cdsteinkuehler/LinuxCNC-RepRap/lcnc2ramps/lcnc2ramps.pdf

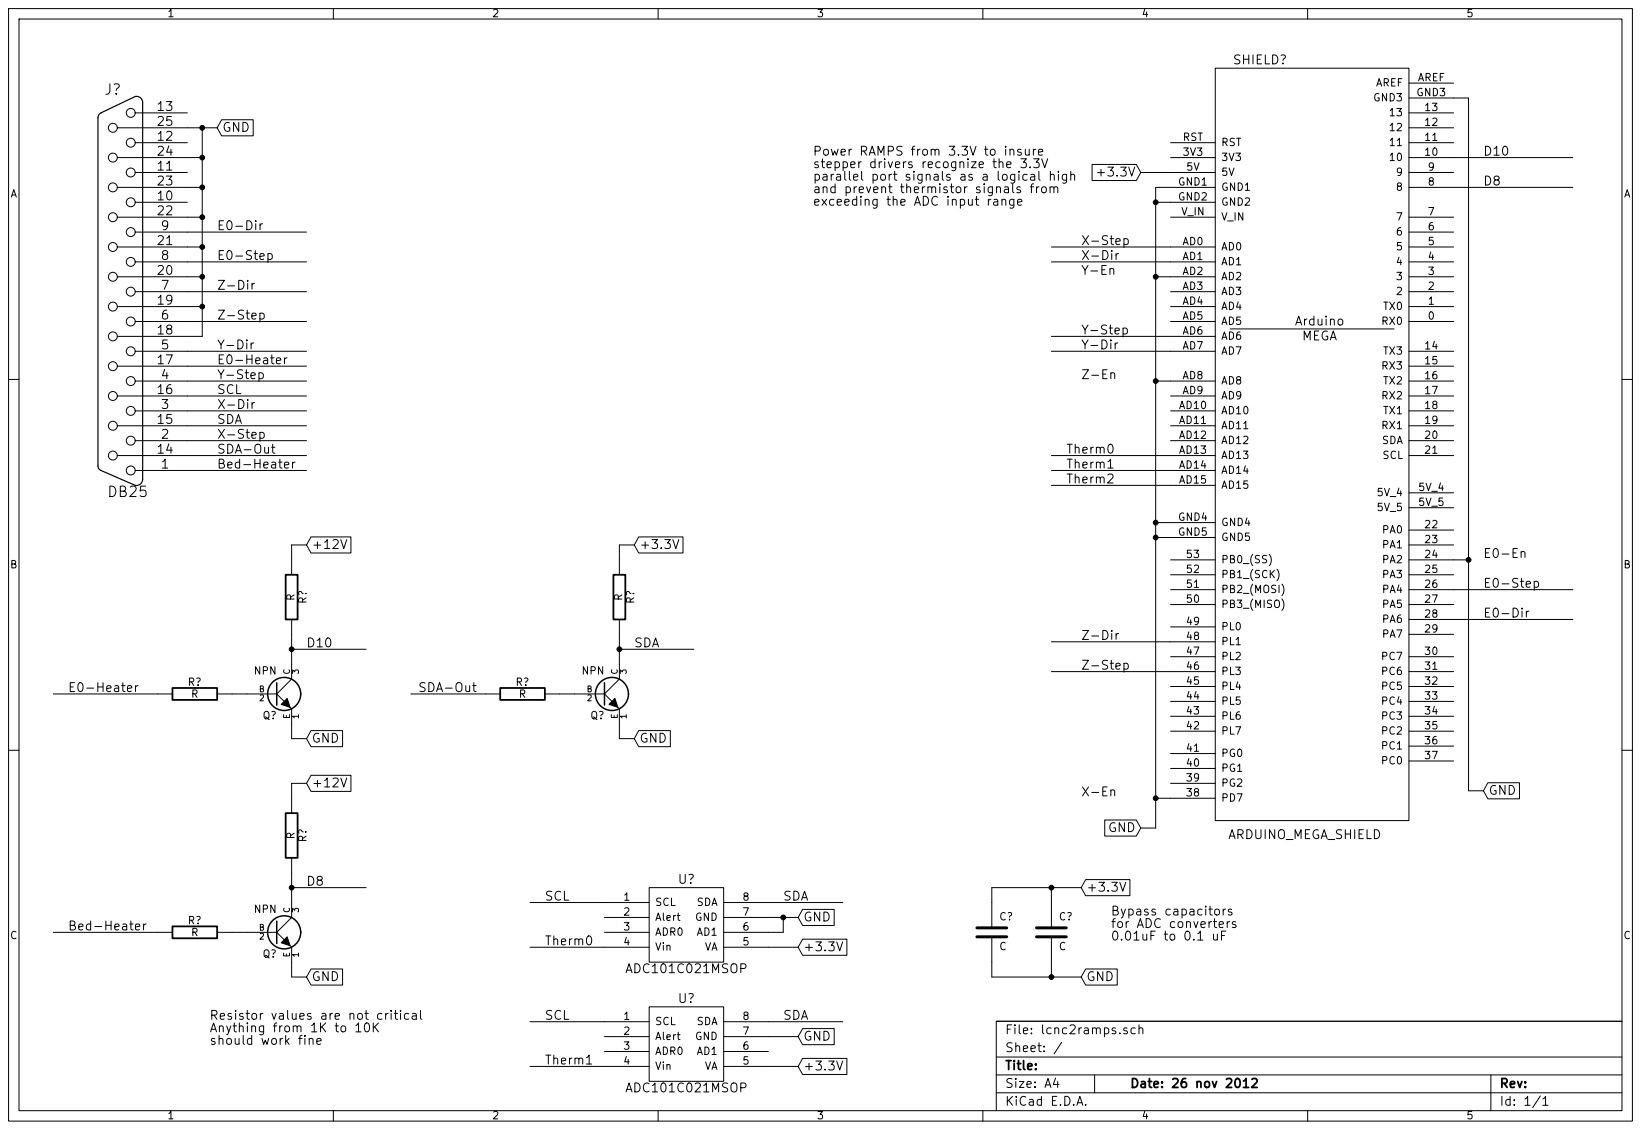
[picture p1: page 1]
