cdsteinkuehler/LinuxCNC-RepRap/(threads)

Thread 1 (2019-08-09):

hardware, kicad

jsoj88p, 2019-08-09:
Hi, I download your schematic but I'm having trouble opening file in kicad, its giving me warning missing libraries, now viewing it on pdf i dont know what value the transistor is ? could you help ? much appreciated
