cdsteinkuehler/LinuxCNC-RepRap/config/MendelMax.ini

# Generated by stepconf at Tue Oct 23 16:56:21 2012
# If you make changes to this file, they will be
# overwritten when you run stepconf again

[EMC]
MACHINE = MendelMax
DEBUG = 0

[DISPLAY]
DISPLAY = axis
EDITOR = gedit
POSITION_OFFSET = RELATIVE
POSITION_FEEDBACK = ACTUAL
MAX_FEED_OVERRIDE = 1.2
INTRO_GRAPHIC = linuxcnc.gif
INTRO_TIME = 5
PROGRAM_PREFIX = /home/charles/linuxcnc/nc_files
INCREMENTS = 5mm 1mm .5mm .1mm .05mm .01mm .005mm
PYVCP = custompanel.xml

[FILTER]
PROGRAM_EXTENSION = .png,.gif,.jpg Greyscale Depth Image
PROGRAM_EXTENSION = .py Python Script
png = image-to-gcode
gif = image-to-gcode
jpg = image-to-gcode
py = python

[TASK]
TASK = milltask
CYCLE_TIME = 0.010

[RS274NGC]
PARAMETER_FILE = linuxcnc.var

[EMCMOT]
EMCMOT = motmod
COMM_TIMEOUT = 1.0
COMM_WAIT = 0.010
BASE_PERIOD = 40000
SERVO_PERIOD = 1000000

[HAL]
HALFILE = MendelMax.hal
HALFILE = custom.hal
POSTGUI_HALFILE = custom_postgui.hal

[TRAJ]
AXES = 4
COORDINATES = X Y Z A
MAX_ANGULAR_VELOCITY = 45.00
DEFAULT_ANGULAR_VELOCITY = 4.50
LINEAR_UNITS = mm
ANGULAR_UNITS = degree
CYCLE_TIME = 0.010
DEFAULT_VELOCITY = 20.00
MAX_LINEAR_VELOCITY = 200.00

[EMCIO]
EMCIO = io
CYCLE_TIME = 0.100
TOOL_TABLE = tool.tbl

[AXIS_0]
TYPE = LINEAR
HOME = 0.0
MAX_VELOCITY = 200.0
MAX_ACCELERATION = 3000.0
STEPGEN_MAXACCEL = 3750.0
SCALE = 80.0
FERROR = 1
MIN_FERROR = .25
MIN_LIMIT = -0.001
MAX_LIMIT = 200.0
HOME_OFFSET = 0.0

[AXIS_1]
TYPE = LINEAR
HOME = 0.0
MAX_VELOCITY = 200.0
MAX_ACCELERATION = 3000.0
STEPGEN_MAXACCEL = 3750.0
SCALE = 80.0
FERROR = 1
MIN_FERROR = .25
MIN_LIMIT = -0.001
MAX_LIMIT = 200.0
HOME_OFFSET = 0.0

[AXIS_2]
TYPE = LINEAR
HOME = 0.0
MAX_VELOCITY = 5.0
MAX_ACCELERATION = 100.0
STEPGEN_MAXACCEL = 125.0
SCALE = 1511.81102362
FERROR = 1
MIN_FERROR = .25
MIN_LIMIT = -4.0
MAX_LIMIT = 200.0
HOME_OFFSET = 0.0

[AXIS_3]
TYPE = ANGULAR
HOME = 0.0
MAX_VELOCITY = 31.8993189453
MAX_ACCELERATION = 3000.0
STEPGEN_MAXACCEL = 3750.0
SCALE = 744.530002058
FERROR = 1
MIN_FERROR = .25
MIN_LIMIT = -9999.0
MAX_LIMIT = 9999.0
HOME_OFFSET = 0.0
