cdsteinkuehler/LinuxCNC-RepRap/config/custom_postgui.hal

# Include your customized HAL commands here
# The commands in this file are run after the AXIS GUI (including PyVCP panel) starts

net e0.temp.meas => pyvcp.Temp
