cdsteinkuehler/LinuxCNC-RepRap/(commit log)

2012-10-24 Initial working version
    These files have been tested and do work, although much tweaking
    remains to be done.
    There is currently no documentation.
    [MendelMax.hal, custom.hal, custom_postgui.hal]
2012-11-26 Added schematic file
    Added a schematic for the interface board that ties a parallel port
    driven by LinuxCNC to an Arduino RAMPS shield, allowing 3D printing
    using LinuxCNC as the machine control software
    [lcnc2ramps.sch]
2012-11-26 Added reference to schematic directory
